ArendJan/mirte-pcb/mirte-bms-breakout/README.md

# Old project, not used anymore as BMS board sometimes breaks and burns.
