ArendJan/mirte-pcb/mirte-master/README.md

# Old project, not used anymore as all parts are moved to mirte-master-bottom pcb.
