ArendJan/mirte-pcb/mirte-master-bottom/mirte-master-bottomv3.step

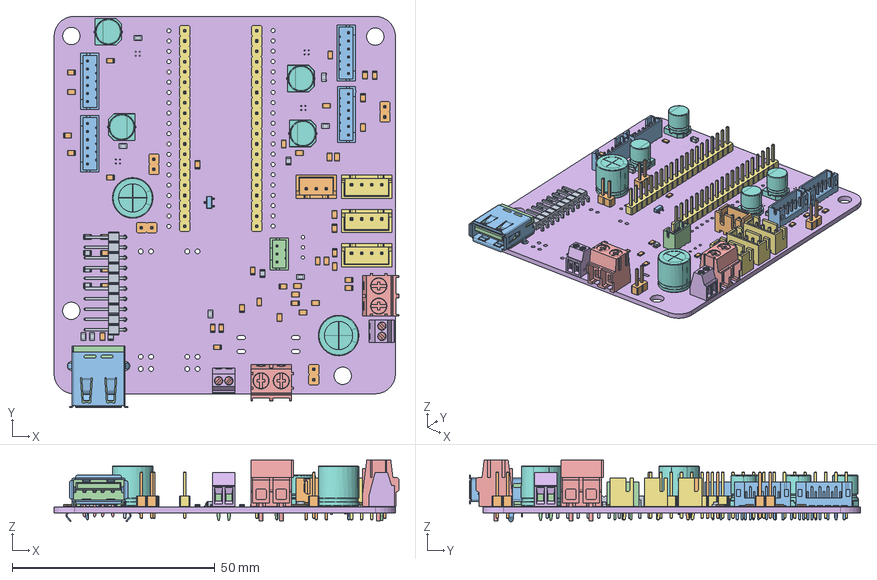
[picture p1: CAD file, 2026-08-18]
mirte-master-bottom/mirte-master-bottomv3.step
85.1 x 96.5 x 15.2 mm
LED_0805_2012Metric x 7
R_0805_2012Metric x 43
USB_A_Molex_67643_Horizontal
PinHeader_1x20_P2.54mm_Vertical x 2
CAP-SMD_BD6.3-L6.6-W6.6-H7.7 x 4
C_0805_2012Metric x 8
PinHeader_1x02_P2.54mm_Vertical x 4
JST_PH_B6B-PH-K_1x06_P2.00mm_Vertical x 4
CONN-TH_DB125-2.54-2P-GN x 2
JST_XH_B4B-XH-A_1x04_P2.50mm_Vertical x 3
CP_Radial_D10.0mm_P3.50mm x 2
PinHeader_1x10_P2.54mm_Horizontal
JST_XH_B3B-XH-A_1x03_P2.50mm_Vertical
SOT-23
JST_PH_B3B-PH-K_1x03_P2.00mm_Vertical
TerminalBlock_Phoenix_PT-1,5-2-5.0-H_1x02_P5.00mm_Horizontal x 2
mirte-master-bottom_PCB
