ArendJan/mirte-pcb/mirte-master-bottom/mirte-master-bottomv3_sm.step

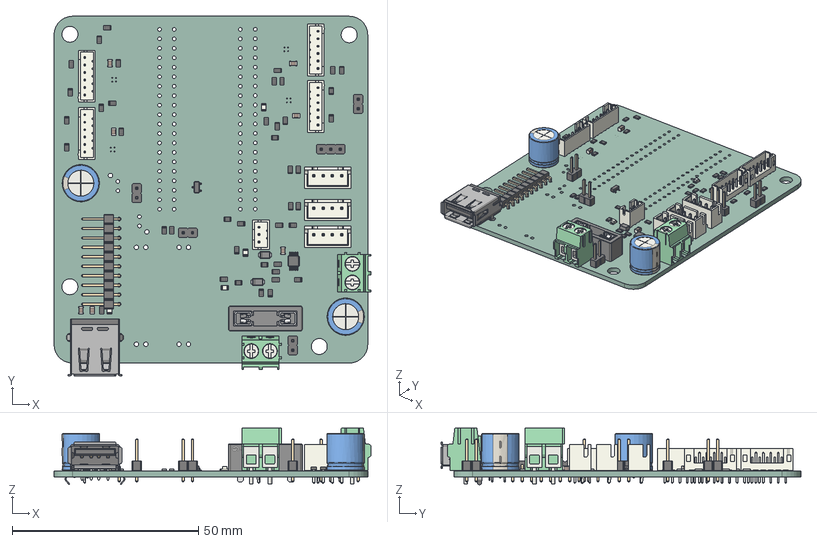
[picture p2: CAD file, 2026-08-18]
mirte-master-bottom/mirte-master-bottomv3_sm.step
85.1 x 96.5 x 15.2 mm
LED_0805_2012Metric x 4
R_0805_2012Metric x 42
USB_A_Molex_67643_Horizontal
JST_B6B_PH_K x 4
C_0805_2012Metric x 7
SOD-123FL_L2.8-W1.9-LS3.7-RD x 2
FUSE-TH_XF-508P-A-B
PinHeader_1x02_P254mm_Vertical x 4
JST_B4B_XH_A x 3
CP_Radial_D100mm_P350mm x 2
PinHeader_1x10_P254mm_Horizontal
PinHeader_1x03_P254mm_Vertical
SOT_23
JST_B3B_PH_K
TerminalBlock_Phoenix_PT_15_2_50_H_1x02_P500mm_Horizontal x 2
VSSOP_10_3x3mm_P05mm
mirte-master-bottom_PCB
