ArendJan/mirte-pcb/simulations/ti431/TL431/TL431_test.asc

R1: res; 1k
U1: TL431
V1: voltage; 0
Named nets: vz, 0
.dc V1 0 5 10m
