ArendJan/mirte-pcb/simulations/pwrOnPCB_simulation.asc

C1: cap; 0.002
C2: cap; 0.0002
D1: diode; MURS120
D3: diode
M1: pmos; AO3423
M2: pmos; AO3423
M3: pmos; AO3423
M4: pmos; AO3423
M5: pmos; AO3423
R1: res; 10k
R2: res; 9k
R3: res; 12k
R4: res; 5
R5: res; 3k9
R6: res; 390
R7: res; 12k
R8: res; 390
R9: res; 390
R10: res; 10
R11: res; 4k7
R12: res; 1k
R13: res; 10
R14: res; 500
R15: res; 10k
R16: res; 10
R17: res; 5k
R18: res; 10k
R19: res; 10
R20: res; 500
S1: sw; MYSW
S2: sw; MYSW
S3: sw; MYSW
S4: sw; MYSW
U1: TL431
V1: voltage; 12
V2: voltage; PULSE(0 1 2 0 0 2)
V3: voltage; PULSE(0 1 7 0 0 0.01)
V4: voltage; PULSE(0 1 0 0 0 0.1)
V5: voltage; 12
V6: voltage; PULSE(0 1 7 0 0 0.1)
V7: voltage; 5
V8: voltage; 12
V9: voltage; 5
V10: voltage; 12
V11: voltage; 12
V12: voltage; SINE(10 2 0.02 1 0 0 1)
Named nets: 0, out, in, sw, mid, REF, tl_cat, out2, out5v
.model myNmos VDMOS(Kp=150 Vto=0.8 Lambda=0)
.model MYSW SW(Ron=0.1 Roff=1Meg Vt=.5 Vh=-.4)
.model myPmos VDMOS(Kp=150 Vto=5.0 Lambda=0)
.tran 0 10 0 0.01
Turn off at start
Turn on at 2s
Turn off at 7s
Some load
Emergency switch simulation
Em switch switches to gnd when ok
