ArendJan/mirte-pcb/(list of files, drawings)

Other design files:
simulations/ti431/t/TL431_PSPICE/TL431.DSN
simulations/ti431/t/TL431_PSPICE/TL431.OLB
simulations/ti431/t/TL431_PSPICE/TL431.opj
