ArendJan/mirte-pcb/(commit log)

2024-06-12 test usb c pioneer pcb
    [mirte_combination.kicad_pcb, mirte_combination.kicad_sch]
2024-10-15 usb b micro instead of c for v0.9
    [mirte_combination.kicad_pcb, mirte_combination.kicad_sch, rotations.csv]
2026-01-19 MM: Fix diode blowing up drv
    [mirte-master-bottom.kicad_pcb, mirte-master-bottom.kicad_sch, motor_connector.kicad_sch, power.kicad_sch, uart_servos.kicad_sch]
2026-01-20 MM: Leds less bright, reorder oled/sonar conns, move parts
    [mirte-master-bottom.kicad_pcb, mirte-master-bottom.kicad_sch, motor_connector.kicad_sch, power.kicad_sch, uart_servos.kicad_sch]
2026-01-23 Cleanups, text fixes for 3rd test pcb with assembly
    [mirte-master-bottom.kicad_pcb, mirte-master-bottom.kicad_sch, motor_conn.kicad_sch, power.kicad_sch, sonar_it.kicad_sch]
2026-01-23 Rename mirte_combination project to mirte_pioneer
    [mirte_combination.kicad_sch, mirte_pioneer.kicad_pcb, mirte_pioneer.kicad_sch]
2026-01-25 Fix CI by removing special case for MIRTE pioneer pcb name
2026-01-29 Rm extra em switch mosfet + fix gnd short A2
    [mirte-master-bottom.kicad_pcb, uart_servos.kicad_sch]
2026-02-03 MM: Add R_trip & bulk cap drv8870
    [mirte-master-bottom.kicad_pcb, motor_connector.kicad_sch]
2026-02-12 MM: motor leds same color, emergency button screw, start button led screw, drc exclusions
    [mirte-master-bottom.kicad_pcb, mirte-master-bottom.kicad_sch, motor_conn.kicad_sch, motor_connector_other_side.kicad_sch, power.kicad_sch]
2026-02-13 MM: em switch input + extra leds power
    [mirte-master-bottom.kicad_pcb, mirte-master-bottom.kicad_sch, motor_connector_other_side.kicad_sch, power.kicad_sch]
2026-02-19 MM: cleanup power before pwr ina reorder
    [low-power.kicad_sch, mirte-master-bottom.kicad_pcb, power.kicad_sch, uart_servos.kicad_sch]
2026-02-19 MM: rework power system, separate em sw input
    [em_sw.kicad_sch, mirte-master-bottom.kicad_pcb, mirte-master-bottom.kicad_sch, power.kicad_sch, uart_servos.kicad_sch]
2026-02-19 MM: improve ground planes
    [mirte-master-bottom.kicad_pcb]
2026-02-19 MM: reorder leds + fix motor conn names
    [mirte-master-bottom.kicad_pcb]
2026-02-24 MM: ERC&DRC fixes + change hbridge cap
    [em_sw.kicad_sch, low-power.kicad_sch, mirte-master-bottom.kicad_pcb, mirte-master-bottom.kicad_sch, motor_conn.kicad_sch, motor_connector.kicad_sch, motor_connector_other_side.kicad_sch, power.kicad_sch]
2026-02-27 MM: order big
    [em_sw.kicad_sch, low-power.kicad_sch, mirte-master-bottom.kicad_pcb, motor_conn.kicad_sch, motor_connector.kicad_sch, motor_connector_other_side.kicad_sch, power.kicad_sch, uart_servos.kicad_sch]
2026-03-03 upd usb sw new kicad
    [mirte-usb-switcher.kicad_pcb]
2026-04-29 cleanup, add readmes old projects + last changes
    [em_sw.kicad_sch, mirte-master-bottom.kicad_sch, motor_conn.kicad_sch, motor_connector.kicad_sch, power.kicad_sch, uart_servos.kicad_sch]
2026-08-18 rm old files
    [mirte-master-bottom.kicad_pcb]
